Jaycar-Electronics/IoT-Wireless-Sign/images/IMAG0461.jpg

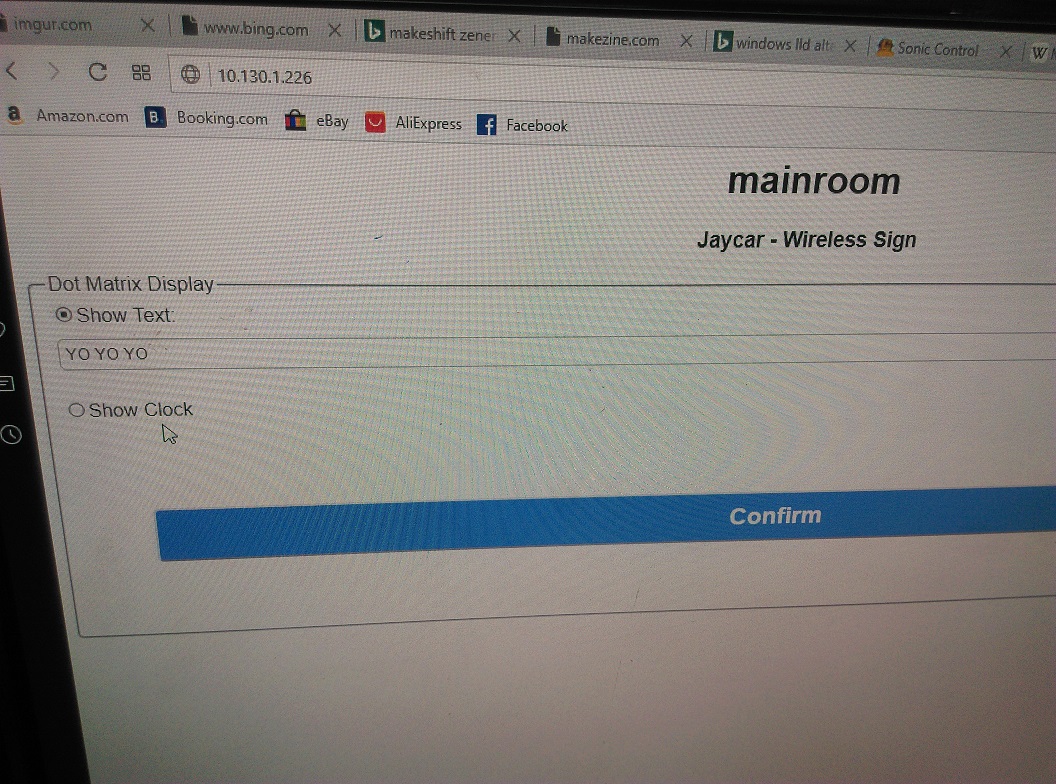
images/IMAG0461.jpg
