Jaycar-Electronics/IoT-Wireless-Sign/images/IMAG0462.jpg

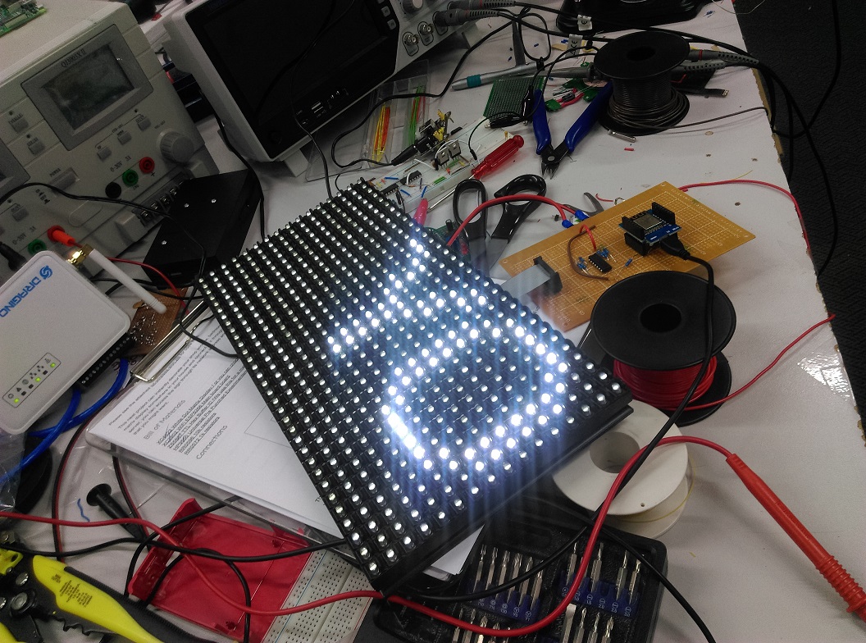
images/IMAG0462.jpg
